amperka-projects/activitymap/png/host_window.png

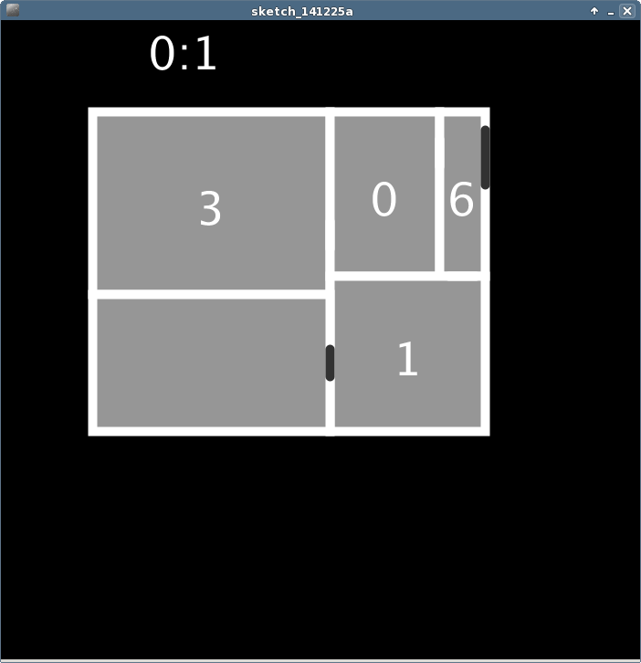
png/host_window.png
