amperka-projects/activitymap/png/scheme.png

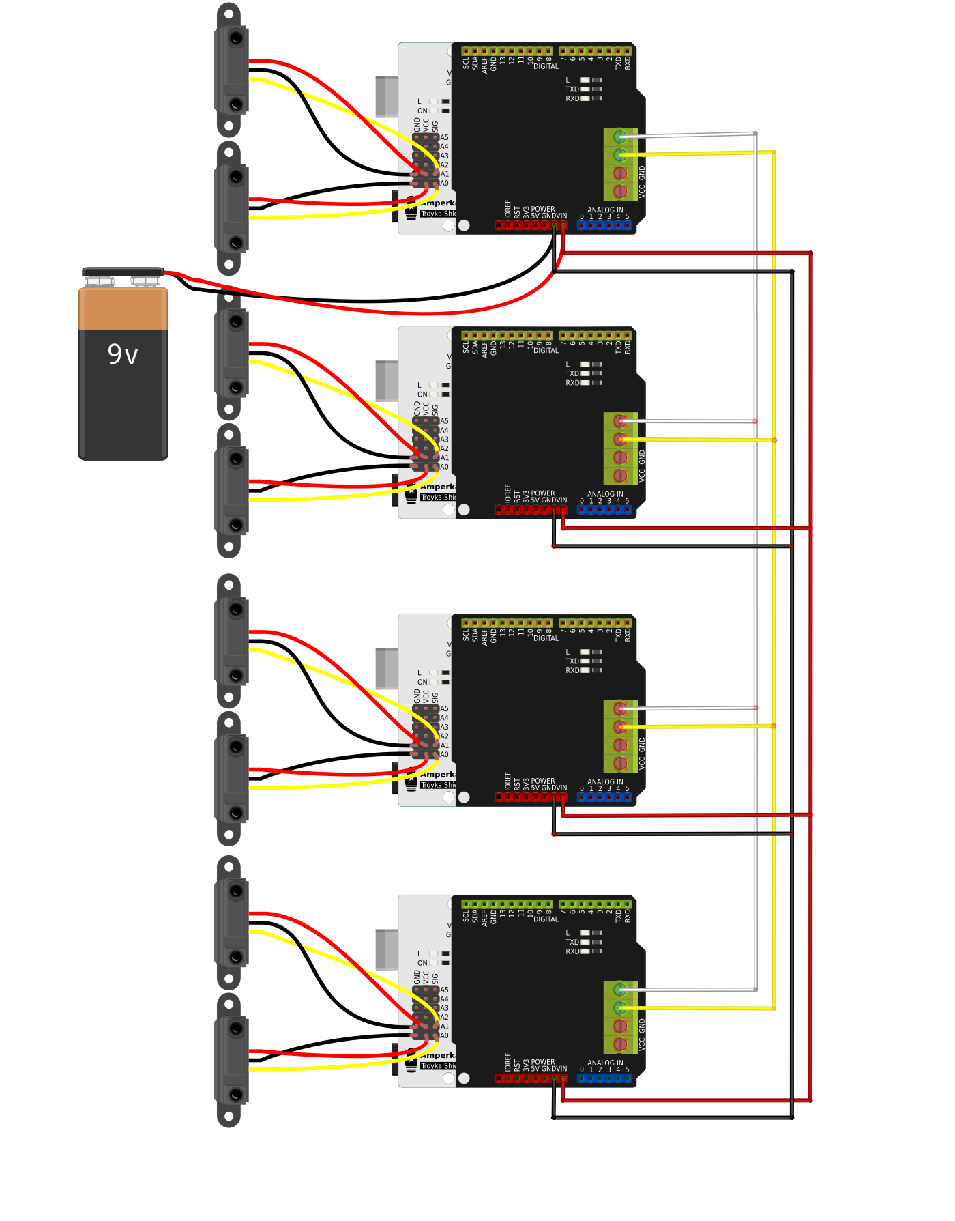
png/scheme.png
