amperka-projects/activitymap/svg/graphics.png

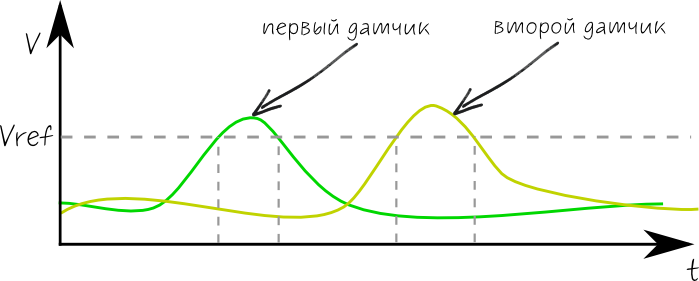
svg/graphics.png
