amperka-projects/activitymap/(list of files, drawings)

Other design files:
fritzing/project.fzz
