amperka-projects/activitymap/(commit log)

2014-12-22 Switching to 1.2V internal reference.
2014-12-24 1. Fritzing scheme added. 2. Clause included.
    [project.fzz]
